buiduyhd5-dot/Product-counter/(list of files, drawings)

Other design files:
mạch proteus/product counter.pdsprj
